Leandro-Milke/Analisador-de-Energia-Eletrica-com-Supervisao-Remota-e-Registro-em-Banco-de-Dados/README.md

# Analisador de energia  elétrica com registro de eventos no banco de dados
Trabalho de conclusão em engenharia elétrica. Este trabalho foi realizado com pouco conhecimento em HTML, JavaScript, PHP e MySQL. Foi o primeiro contato com estas estruturas de programação e partiu da vontade de aprender algo diferente que pudesse acrescentar muito aos meus conhecimentos já adquiridos ao longo da graduação em engenharia elétrica.
