Leandro-Milke/Analisador-de-Energia-Eletrica-com-Supervisao-Remota-e-Registro-em-Banco-de-Dados/HTML-CSS-PHP-Mysql/imagem/RedeAlimentandoG_Falha.png

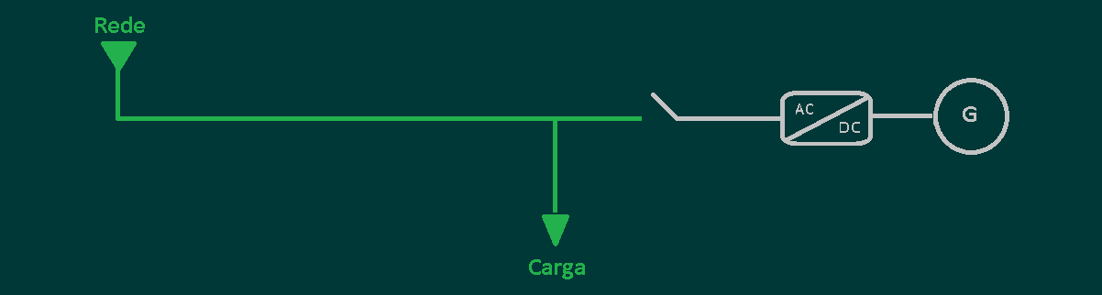
HTML-CSS-PHP-Mysql/imagem/RedeAlimentandoG_Falha.png
